conquat/SmartBike/imgs/Schematic_MainBoard.pdf

## ARDUINOMEGA

IC1

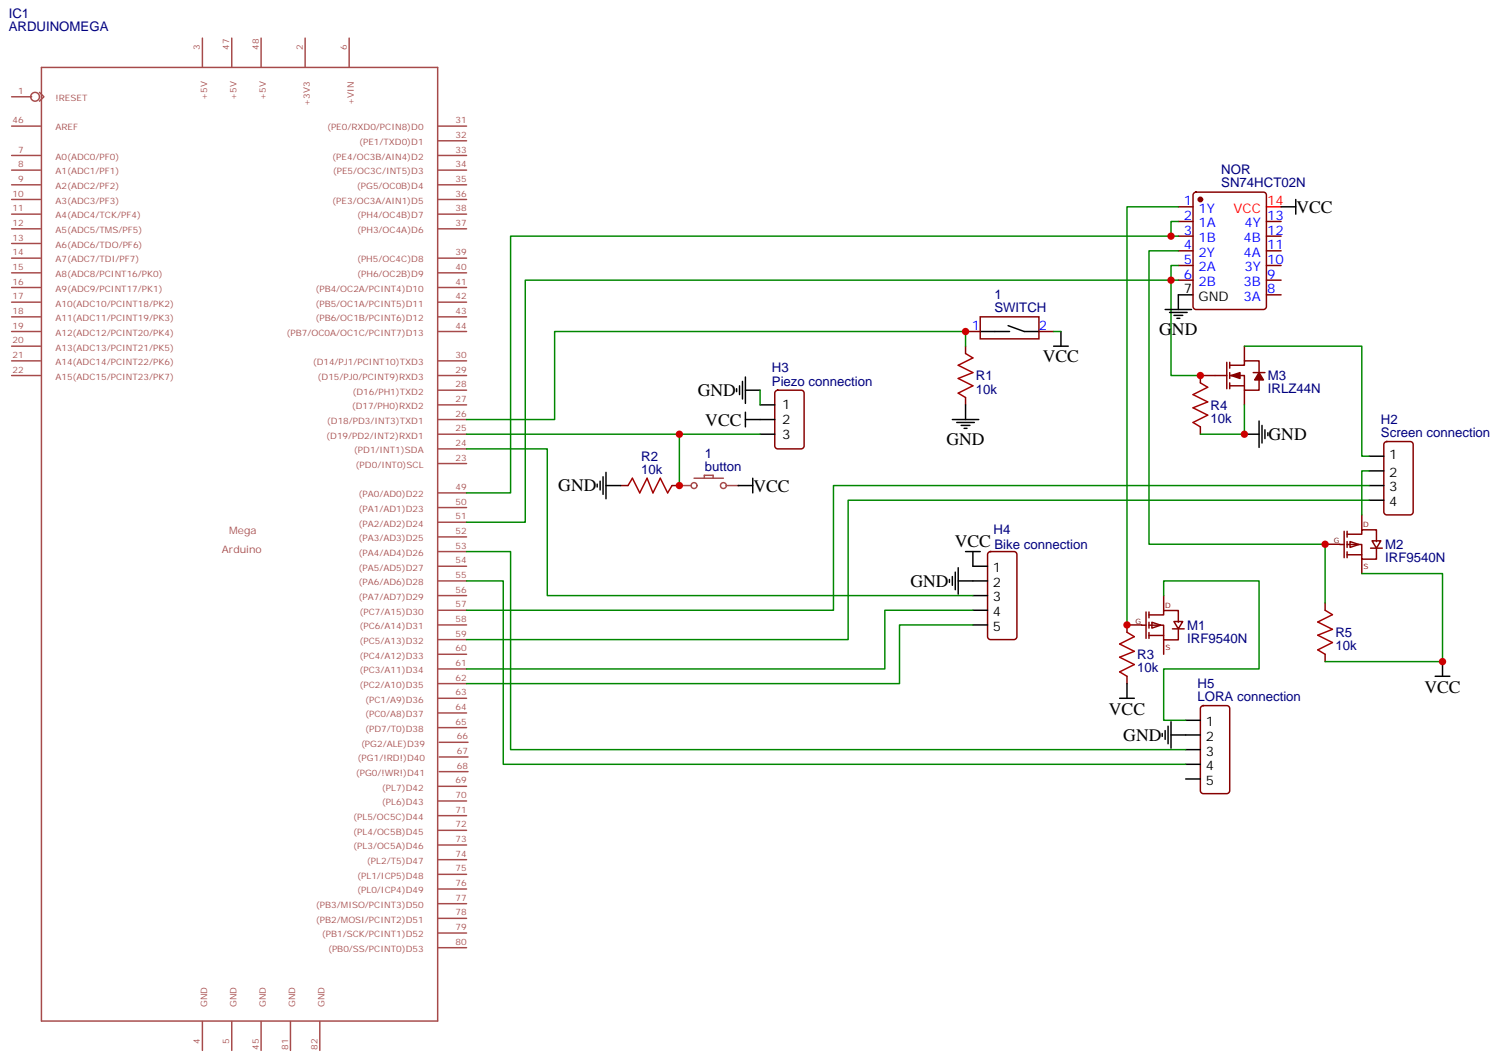
[picture p4: page 1]
