conquat/SmartBike/imgs/Schematic_Piezo amplifier.pdf

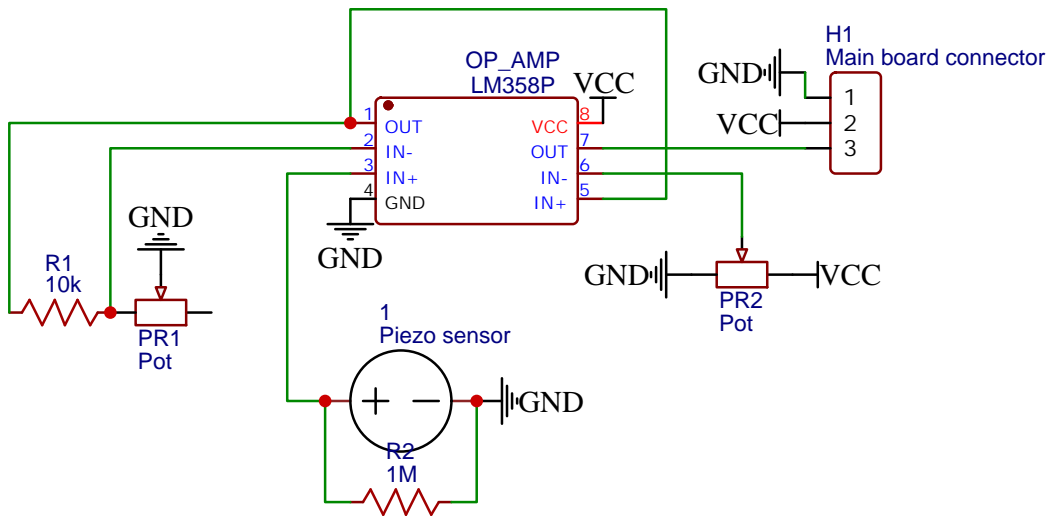
[picture p5: page 1]
